NecronLabs/Esp32_wireless_synaptics_touchpad/res/i2c_test_terminal_output.png

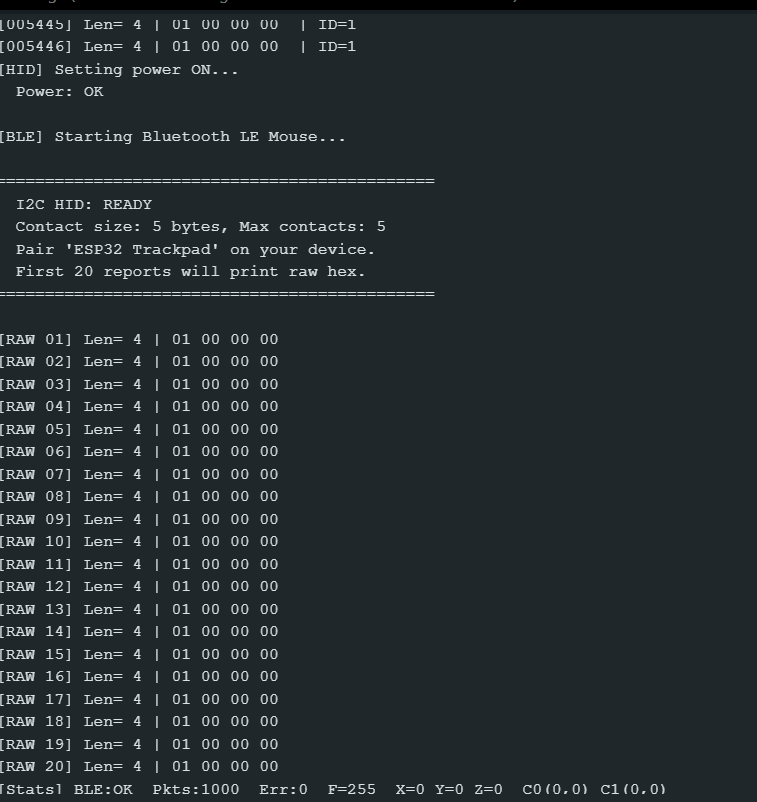
res/i2c_test_terminal_output.png
